HasanFairuz/joystick-controlled-claw-arm/cad/controller-enclosure/Rear Case v2.STL

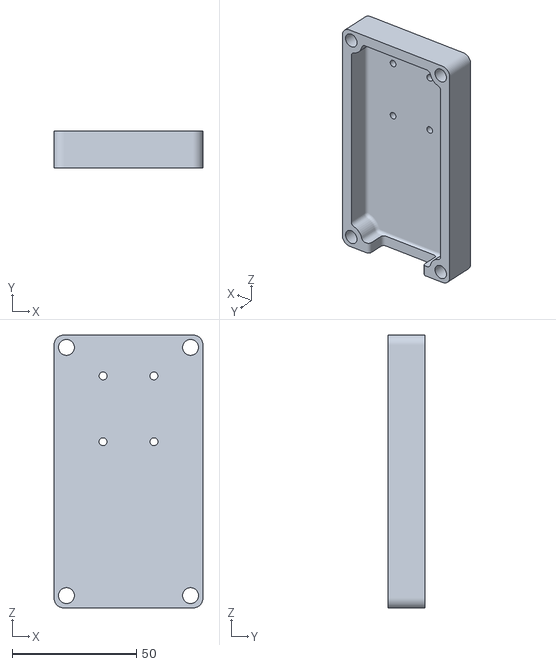
[picture p6: CAD file, 2026-10-29]
cad/controller-enclosure/Rear Case v2.STL
60.0 x 15.0 x 110.0
