HasanFairuz/joystick-controlled-claw-arm/cad/mechanical-arm/Boss-Extrude1[7].STL

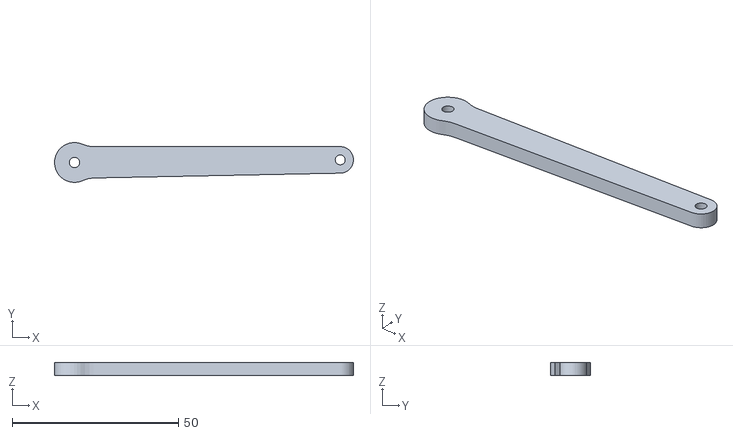
[picture p7: CAD file, 2026-10-29]
cad/mechanical-arm/Boss-Extrude1[7].STL
90.0 x 12.0 x 4.00
