HasanFairuz/joystick-controlled-claw-arm/cad/controller-enclosure/Front Plate v2.STL

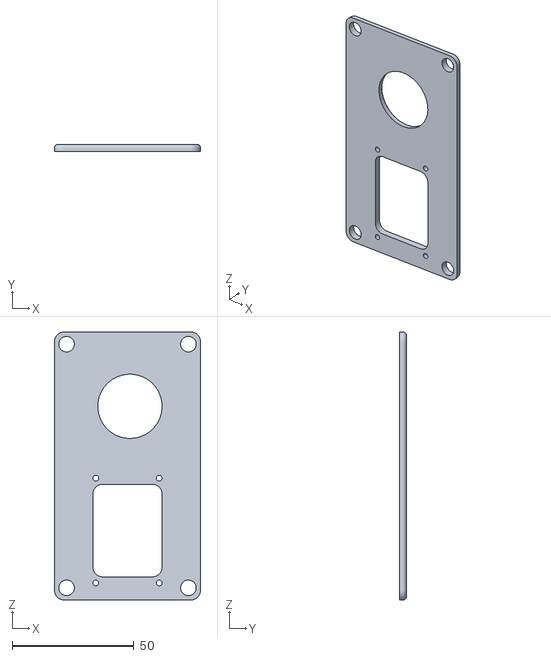
[picture p8: CAD file, 2026-10-29]
cad/controller-enclosure/Front Plate v2.STL
60.0 x 3.00 x 110.0
