HasanFairuz/joystick-controlled-claw-arm/cad/mechanical-arm/Boss-Extrude1[13].STL

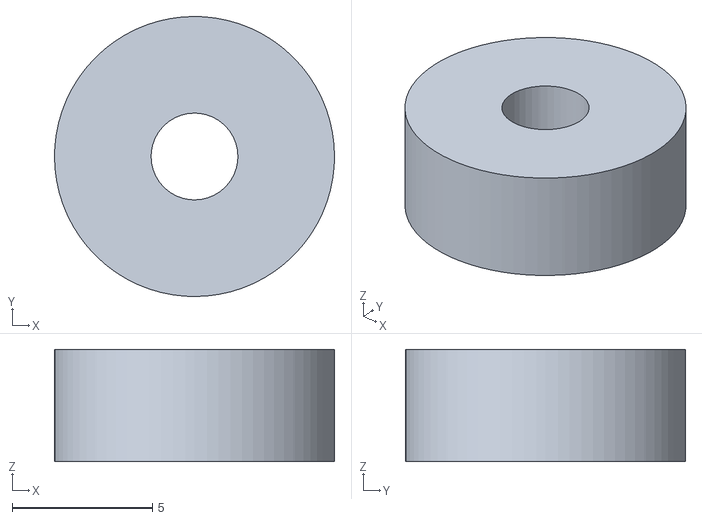
[picture p9: CAD file, 2026-10-29]
cad/mechanical-arm/Boss-Extrude1[13].STL
10.0 x 10.0 x 4.00
