HasanFairuz/joystick-controlled-claw-arm/cad/mechanical-arm/Boss-Extrude1[27].STL

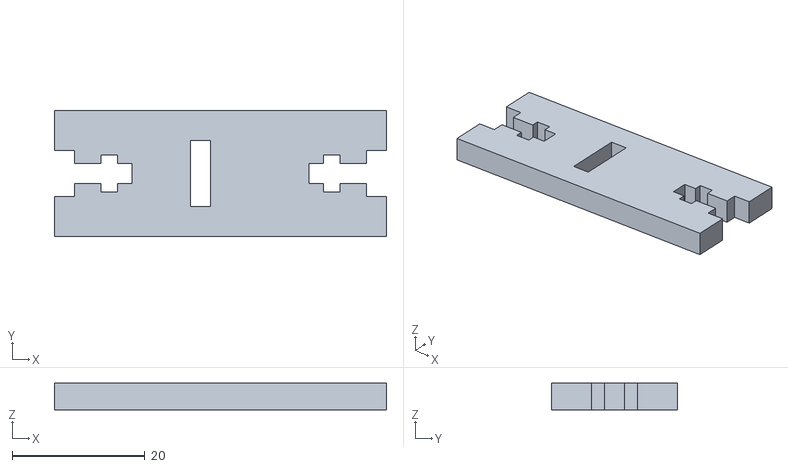
[picture p10: CAD file, 2026-10-29]
cad/mechanical-arm/Boss-Extrude1[27].STL
50.0 x 19.0 x 4.00
