HasanFairuz/joystick-controlled-claw-arm/cad/mechanical-arm/Boss-Extrude1[18].STL

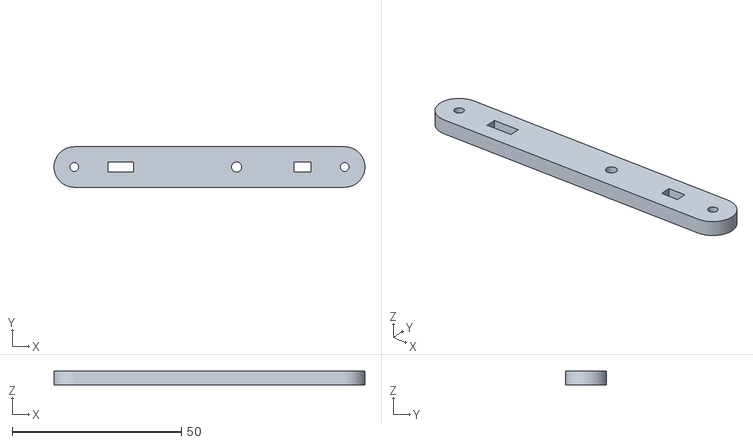
[picture p11: CAD file, 2026-10-29]
cad/mechanical-arm/Boss-Extrude1[18].STL
92.0 x 12.0 x 4.00
