HasanFairuz/joystick-controlled-claw-arm/cad/mechanical-arm/Boss-Extrude1[12].STL

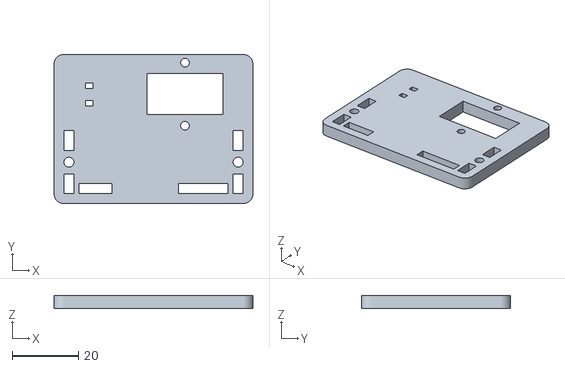
[picture p12: CAD file, 2026-10-29]
cad/mechanical-arm/Boss-Extrude1[12].STL
60.0 x 45.0 x 4.00
