HasanFairuz/joystick-controlled-claw-arm/cad/mechanical-arm/Boss-Extrude1[5].STL

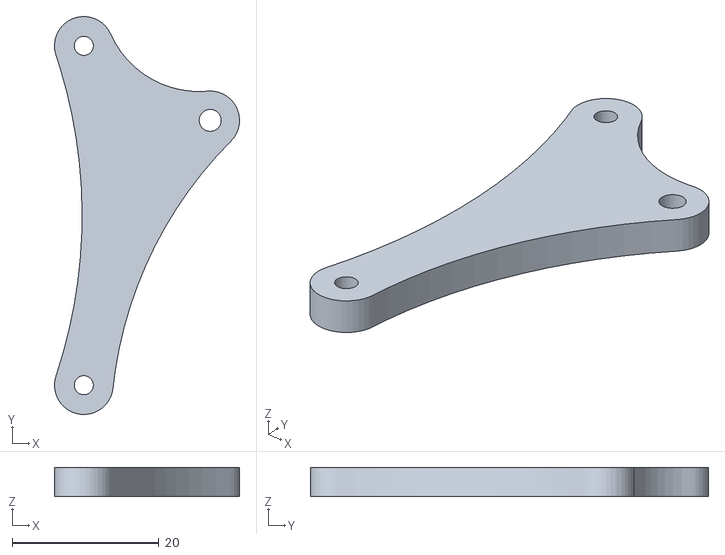
[picture p13: CAD file, 2026-10-29]
cad/mechanical-arm/Boss-Extrude1[5].STL
25.2 x 54.3 x 4.00
