HasanFairuz/joystick-controlled-claw-arm/cad/mechanical-arm/Boss-Extrude1[25].STL

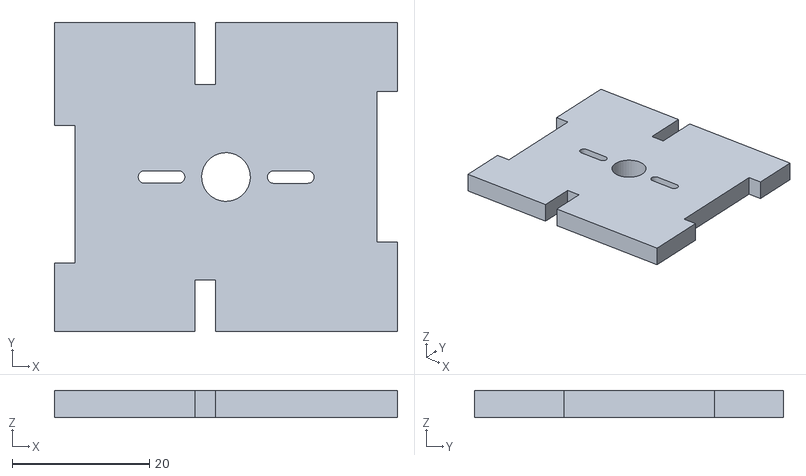
[picture p14: CAD file, 2026-10-29]
cad/mechanical-arm/Boss-Extrude1[25].STL
50.0 x 45.0 x 4.00
