HasanFairuz/joystick-controlled-claw-arm/cad/mechanical-arm/Boss-Extrude1[1].STL

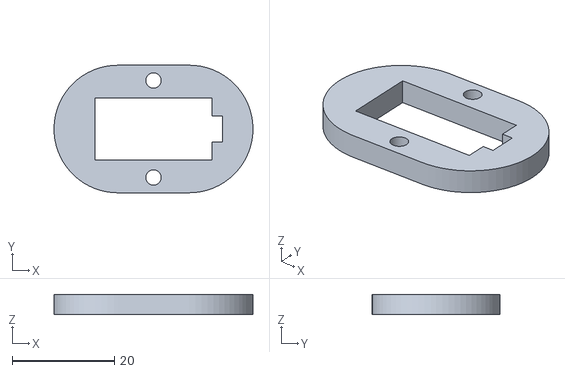
[picture p15: CAD file, 2026-10-29]
cad/mechanical-arm/Boss-Extrude1[1].STL
39.0 x 25.0 x 4.00
