HasanFairuz/joystick-controlled-claw-arm/cad/mechanical-arm/Boss-Extrude2.STL

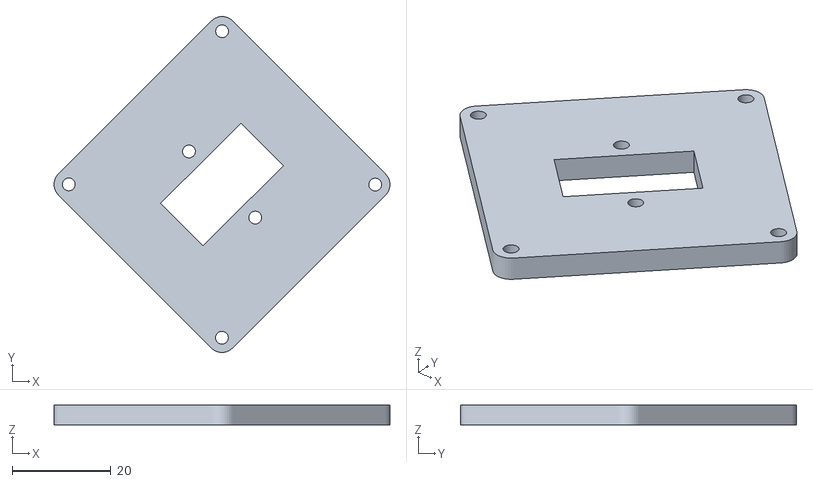
[picture p16: CAD file, 2026-10-29]
cad/mechanical-arm/Boss-Extrude2.STL
68.2 x 68.2 x 4.00
