HasanFairuz/joystick-controlled-claw-arm/cad/mechanical-arm/Boss-Extrude1[23].STL

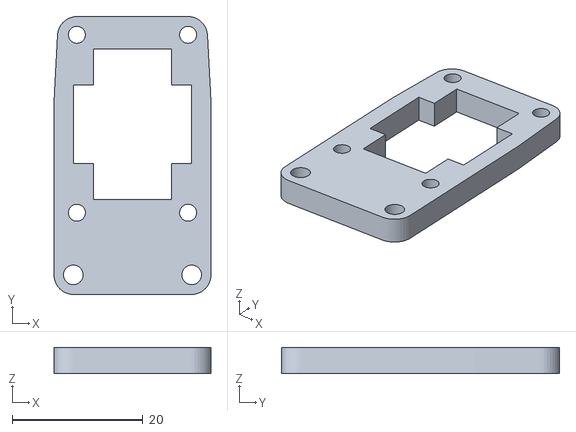
[picture p17: CAD file, 2026-10-29]
cad/mechanical-arm/Boss-Extrude1[23].STL
24.0 x 42.5 x 4.00
