HasanFairuz/joystick-controlled-claw-arm/cad/mechanical-arm/Boss-Extrude1[6].STL

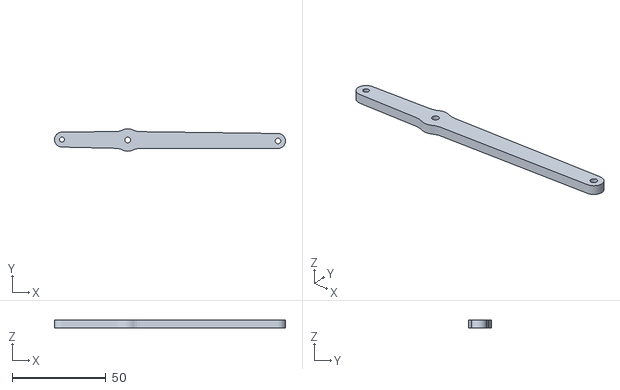
[picture p18: CAD file, 2026-10-29]
cad/mechanical-arm/Boss-Extrude1[6].STL
123.0 x 12.0 x 4.00
