HasanFairuz/joystick-controlled-claw-arm/cad/mechanical-arm/Boss-Extrude1[10].STL

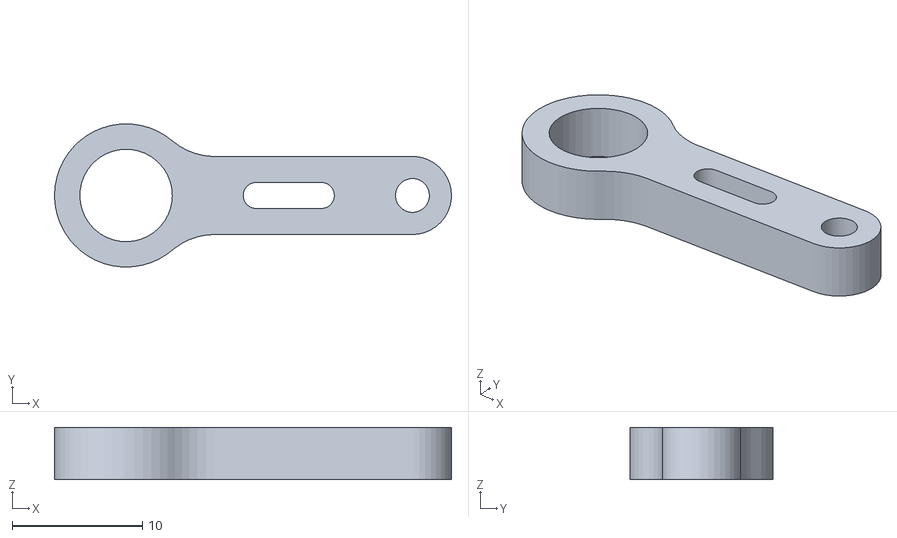
[picture p19: CAD file, 2026-10-29]
cad/mechanical-arm/Boss-Extrude1[10].STL
30.5 x 11.0 x 4.00
