HasanFairuz/joystick-controlled-claw-arm/cad/mechanical-arm/Boss-Extrude1[30].STL

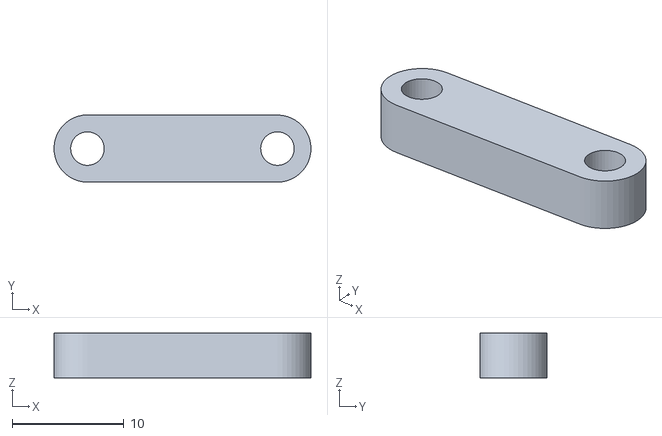
[picture p20: CAD file, 2026-10-29]
cad/mechanical-arm/Boss-Extrude1[30].STL
23.0 x 6.02 x 4.00
