HasanFairuz/joystick-controlled-claw-arm/cad/mechanical-arm/Boss-Extrude1[9].STL

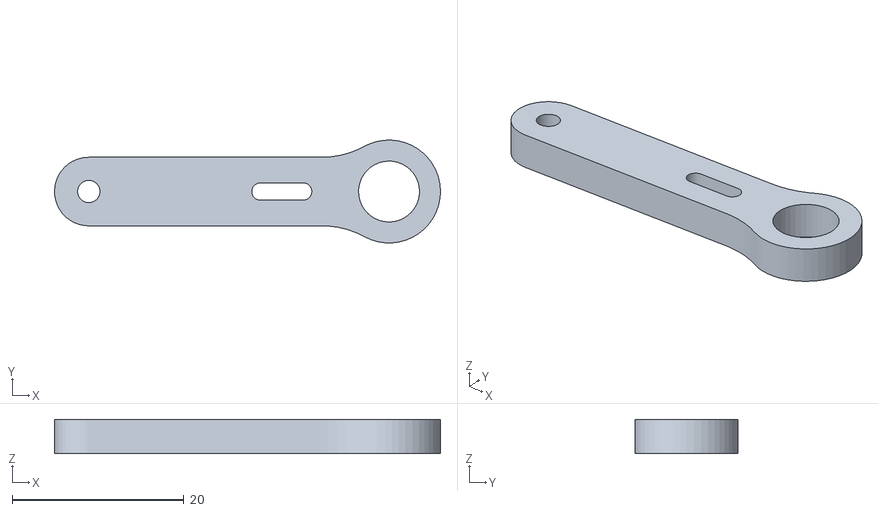
[picture p21: CAD file, 2026-10-29]
cad/mechanical-arm/Boss-Extrude1[9].STL
45.0 x 12.0 x 4.00
