HasanFairuz/joystick-controlled-claw-arm/cad/mechanical-arm/Boss-Extrude1[33].STL

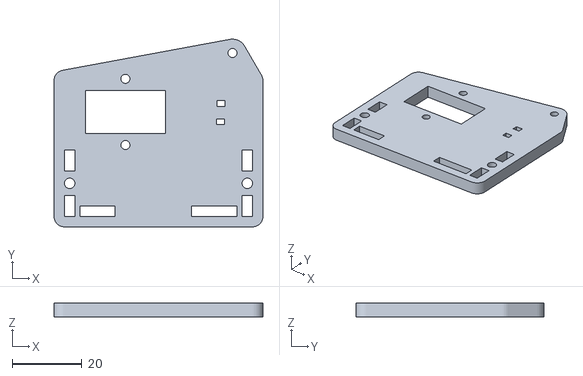
[picture p22: CAD file, 2026-10-29]
cad/mechanical-arm/Boss-Extrude1[33].STL
60.0 x 53.9 x 4.00
