HasanFairuz/joystick-controlled-claw-arm/cad/mechanical-arm/Boss-Extrude1[34].STL

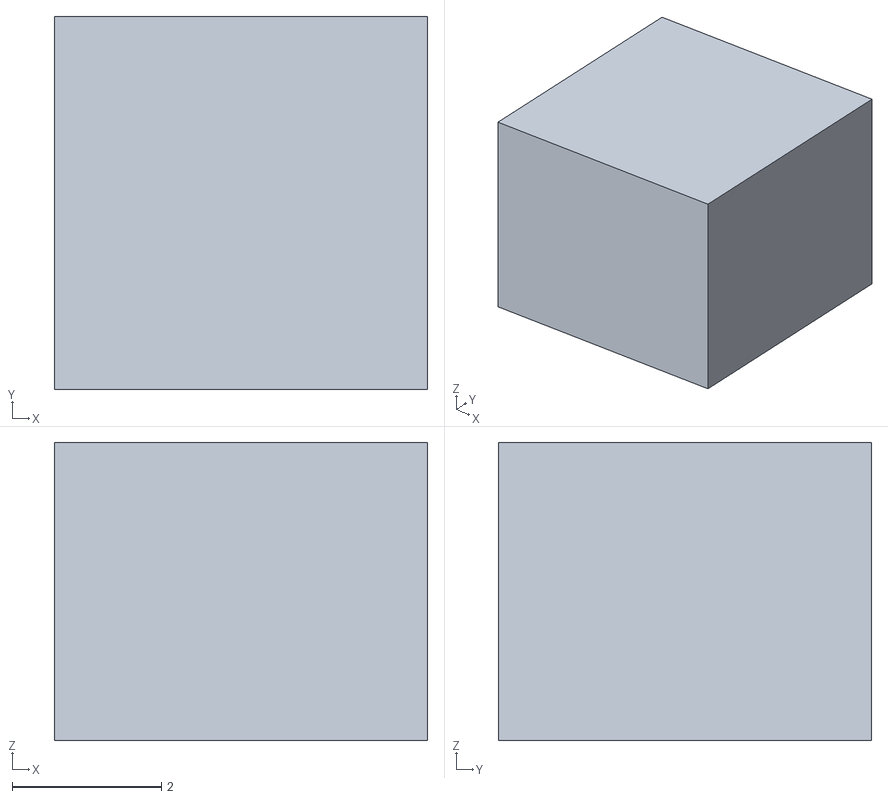
[picture p23: CAD file, 2026-10-29]
cad/mechanical-arm/Boss-Extrude1[34].STL
5.00 x 5.00 x 4.00
