HasanFairuz/joystick-controlled-claw-arm/cad/mechanical-arm/Boss-Extrude1[15].STL

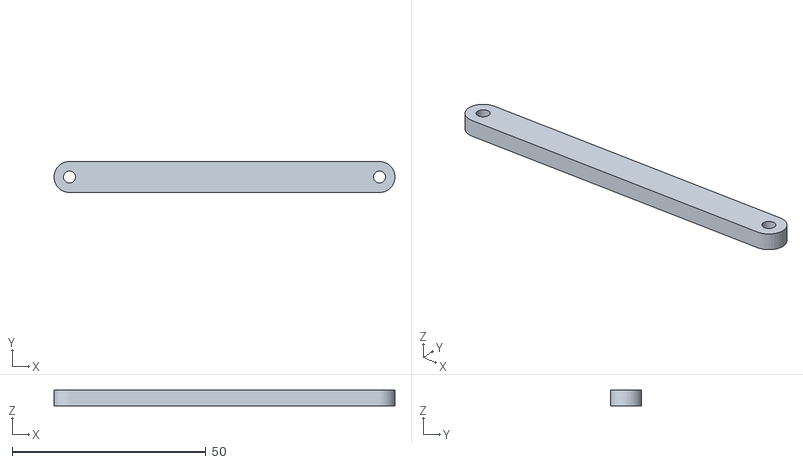
[picture p24: CAD file, 2026-10-29]
cad/mechanical-arm/Boss-Extrude1[15].STL
88.0 x 8.00 x 4.00
