HasanFairuz/joystick-controlled-claw-arm/cad/mechanical-arm/Boss-Extrude1[11].STL

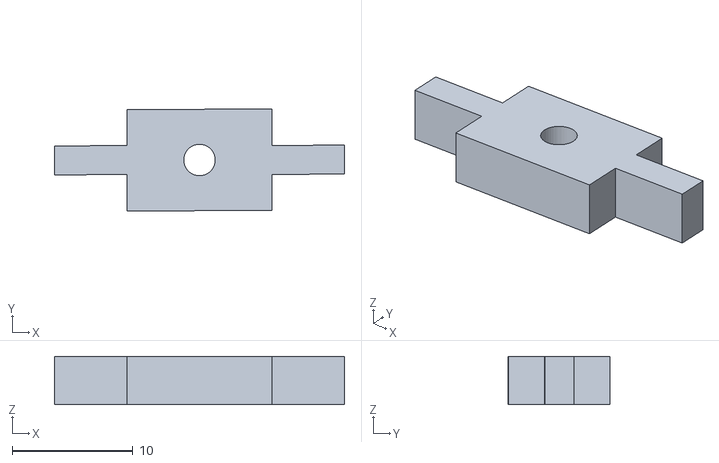
[picture p25: CAD file, 2026-10-29]
cad/mechanical-arm/Boss-Extrude1[11].STL
24.0 x 8.43 x 4.00
