HasanFairuz/joystick-controlled-claw-arm/cad/mechanical-arm/Boss-Extrude1[29].STL

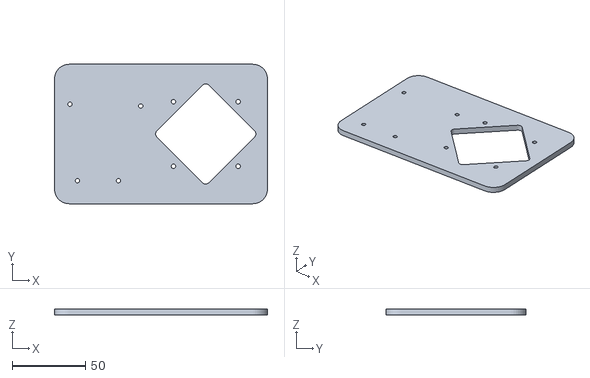
[picture p26: CAD file, 2026-10-29]
cad/mechanical-arm/Boss-Extrude1[29].STL
145.0 x 95.0 x 4.00
