HasanFairuz/joystick-controlled-claw-arm/cad/mechanical-arm/Boss-Extrude1[8].STL

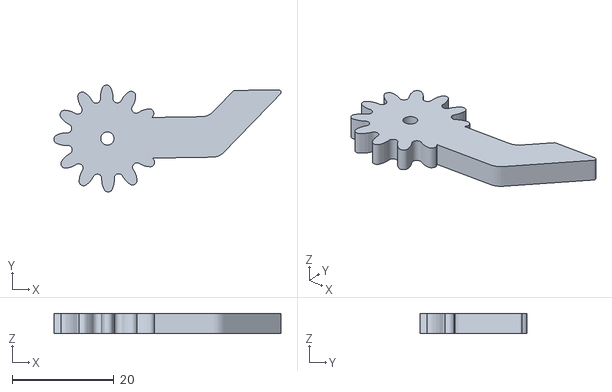
[picture p27: CAD file, 2026-10-29]
cad/mechanical-arm/Boss-Extrude1[8].STL
44.7 x 21.0 x 4.00
