HasanFairuz/joystick-controlled-claw-arm/cad/mechanical-arm/Boss-Extrude1[26].STL

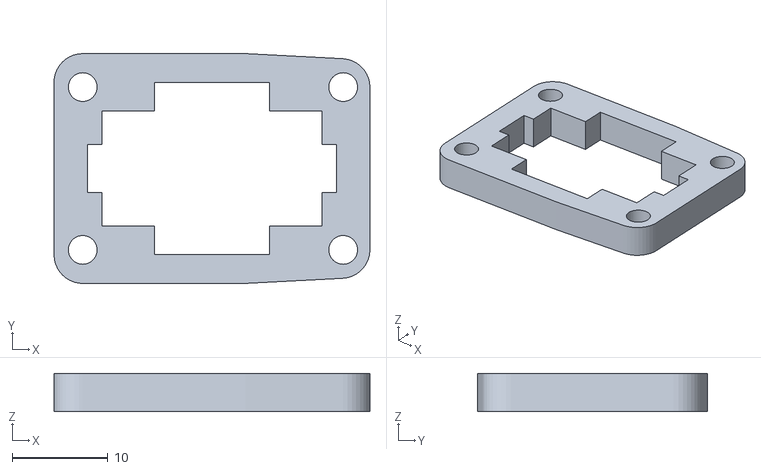
[picture p28: CAD file, 2026-10-29]
cad/mechanical-arm/Boss-Extrude1[26].STL
33.0 x 24.0 x 4.00
