HasanFairuz/joystick-controlled-claw-arm/cad/mechanical-arm/Boss-Extrude1[22].STL

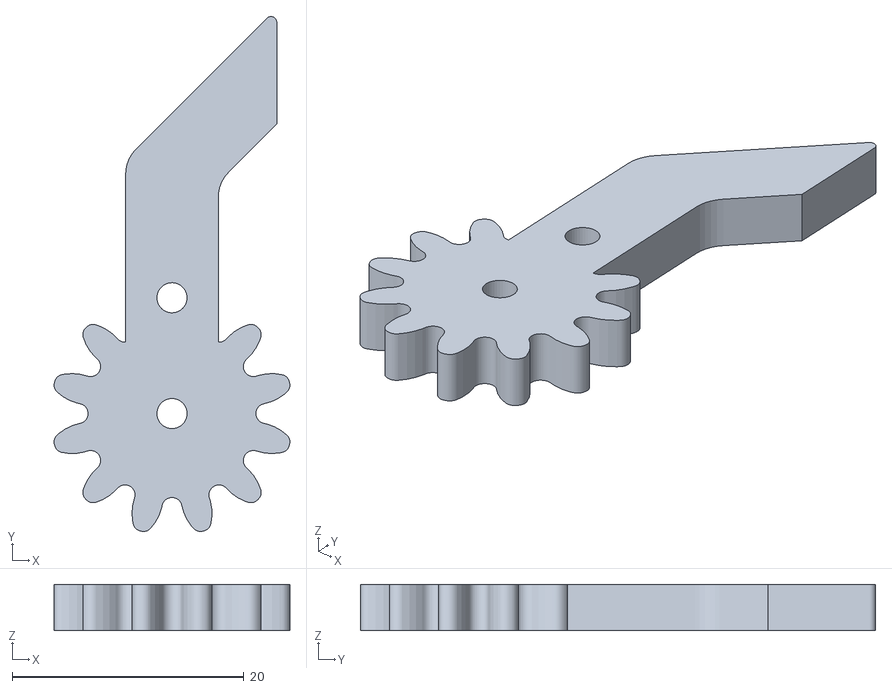
[picture p29: CAD file, 2026-10-29]
cad/mechanical-arm/Boss-Extrude1[22].STL
20.4 x 44.5 x 4.00
