HasanFairuz/joystick-controlled-claw-arm/cad/mechanical-arm/Boss-Extrude1[31].STL

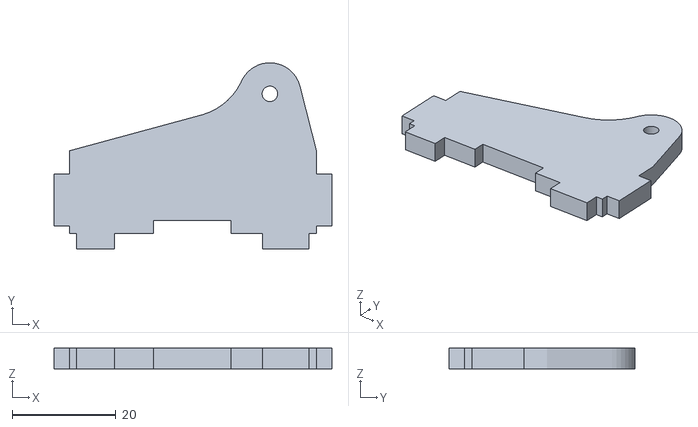
[picture p30: CAD file, 2026-10-29]
cad/mechanical-arm/Boss-Extrude1[31].STL
53.7 x 36.0 x 4.00
