HasanFairuz/joystick-controlled-claw-arm/cad/mechanical-arm/Boss-Extrude1[14].STL

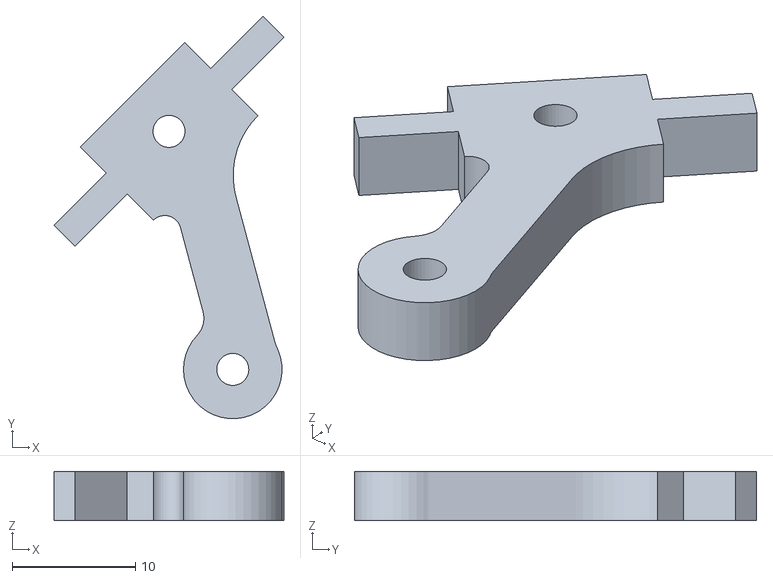
[picture p31: CAD file, 2026-10-29]
cad/mechanical-arm/Boss-Extrude1[14].STL
18.7 x 32.6 x 4.00
