HasanFairuz/joystick-controlled-claw-arm/(list of files, cad)

Other CAD files:
cad/mechanical-arm/Boss-Extrude1[20].STL
cad/mechanical-arm/Boss-Extrude1[24].STL
cad/mechanical-arm/Boss-Extrude1[21].STL
cad/mechanical-arm/Boss-Extrude1[3].STL
cad/mechanical-arm/Boss-Extrude1[4].STL
cad/mechanical-arm/Boss-Extrude1[2].STL
cad/mechanical-arm/Boss-Extrude1[28].STL
cad/mechanical-arm/Boss-Extrude1[16].STL
cad/mechanical-arm/Boss-Extrude1[17].STL
cad/mechanical-arm/Boss-Extrude1[32].STL
cad/mechanical-arm/Boss-Extrude1[19].STL
