HasanFairuz/joystick-controlled-claw-arm/media/Claw Arm - Isometric.jpg

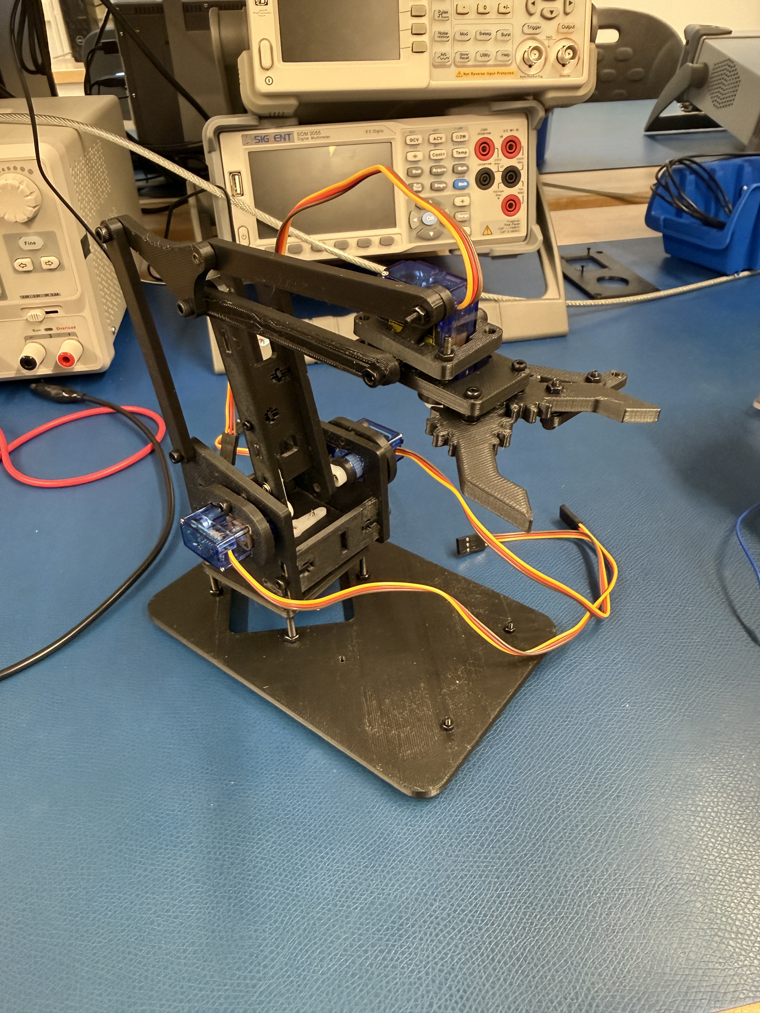
[picture p1: media/Claw Arm - Isometric.jpg]
media/Claw Arm - Isometric.jpg
