HasanFairuz/joystick-controlled-claw-arm/media/Claw Arm - Side View.jpg

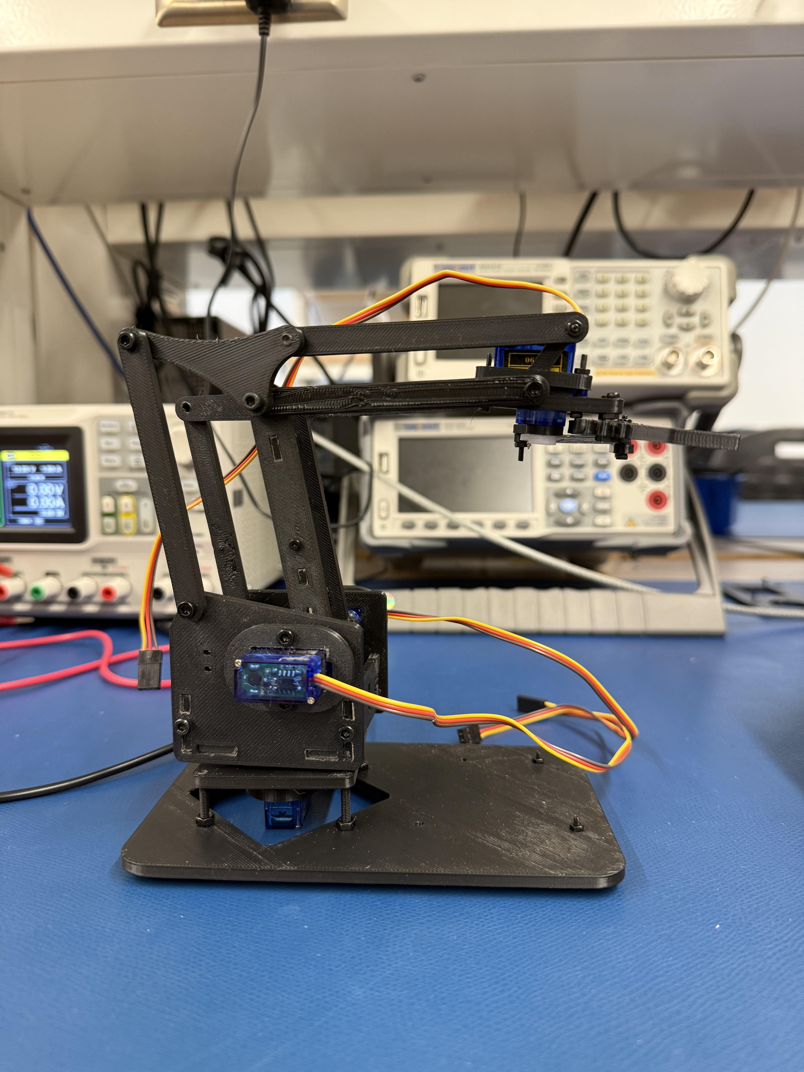
[picture p2: media/Claw Arm - Side View.jpg]
media/Claw Arm - Side View.jpg
