HasanFairuz/joystick-controlled-claw-arm/media/Joystick Interface - Internal.jpg

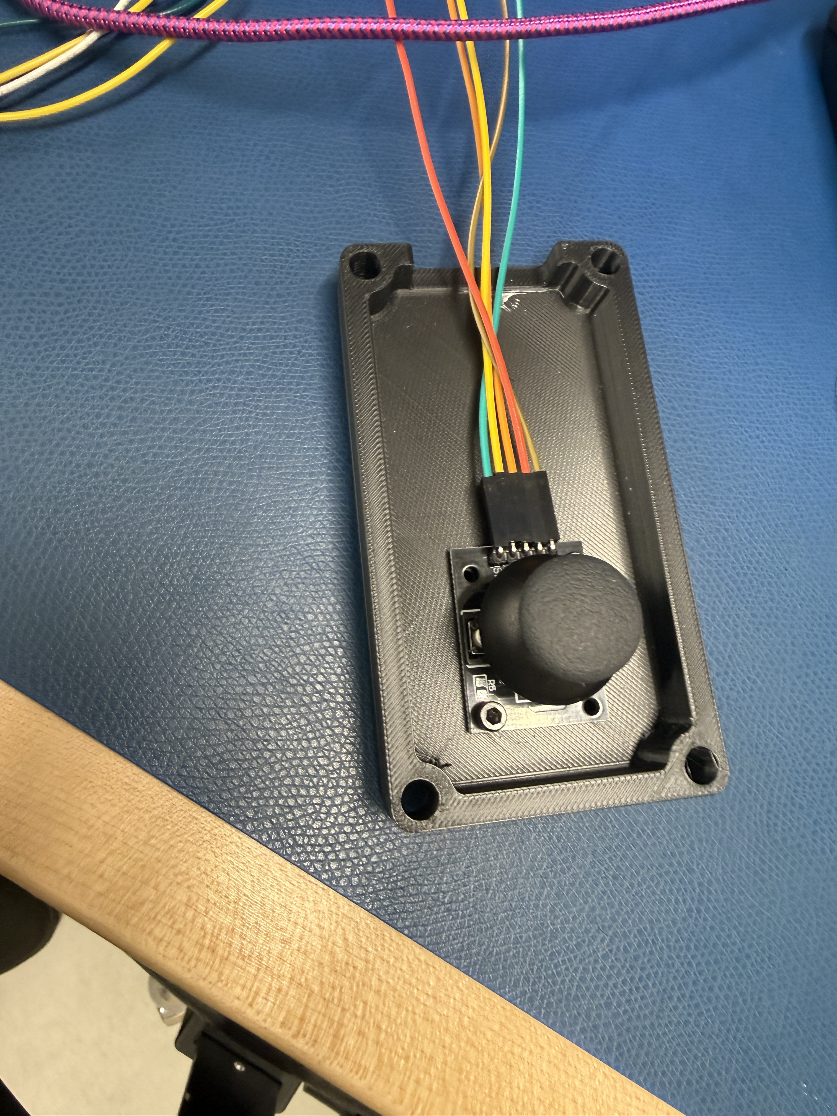
[picture p4: media/Joystick Interface - Internal.jpg]
media/Joystick Interface - Internal.jpg
