HasanFairuz/joystick-controlled-claw-arm/media/Joystick Interface - Assembled.jpg

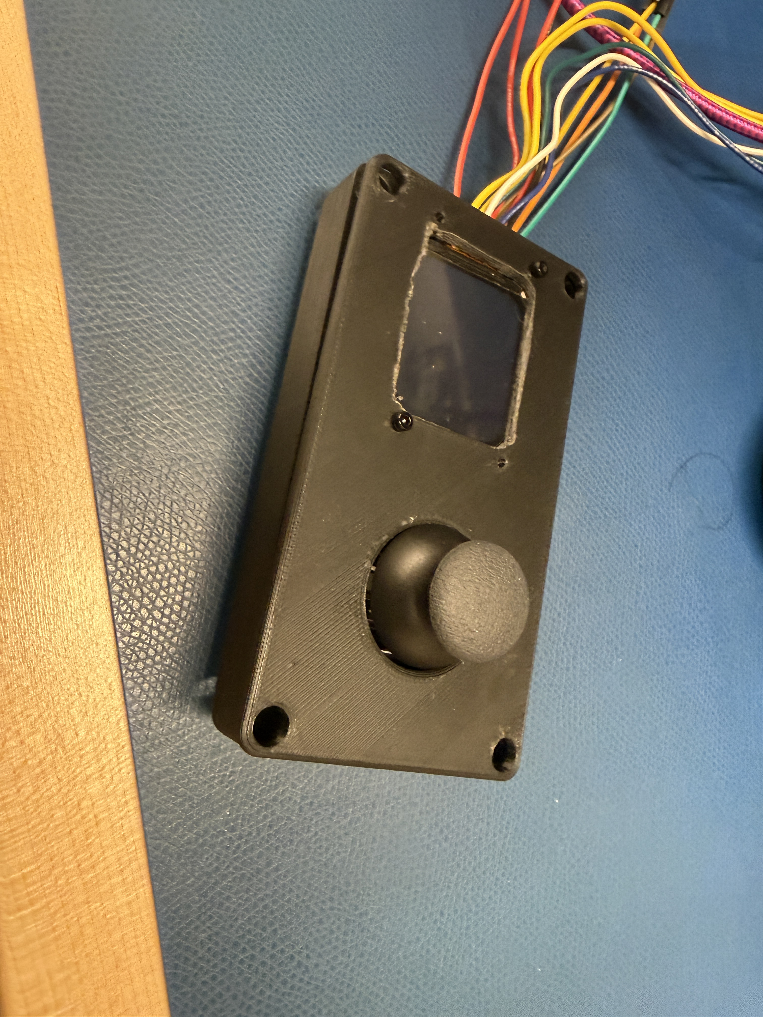
[picture p5: media/Joystick Interface - Assembled.jpg]
media/Joystick Interface - Assembled.jpg
